johnrenner94/Encoder_IMU_Odometry_Robot/Media/ModifiedLowerChassis.jpg

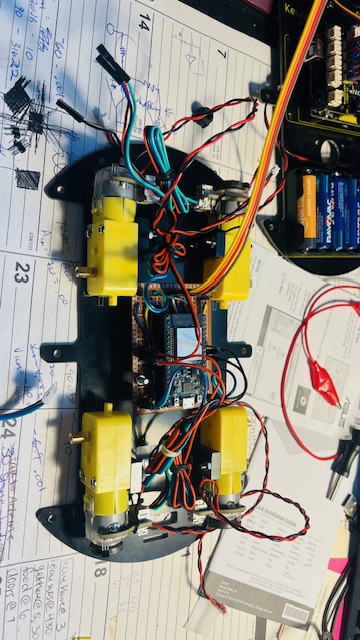
Media/ModifiedLowerChassis.jpg
