johnrenner94/Encoder_IMU_Odometry_Robot/Media/TestSetup.jpg

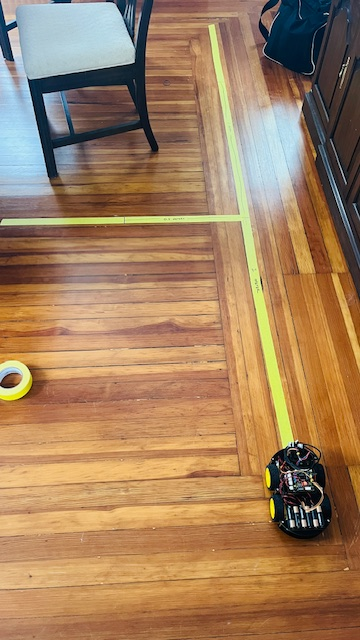
Media/TestSetup.jpg
