johnrenner94/Encoder_IMU_Odometry_Robot/Media/BreakoutBoard_no_ESP32.jpg

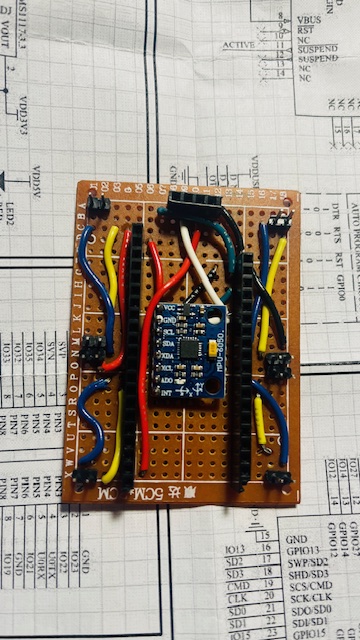
Media/BreakoutBoard_no_ESP32.jpg
