johnrenner94/Encoder_IMU_Odometry_Robot/Media/BreakoutBoard_with_ESP32.jpg

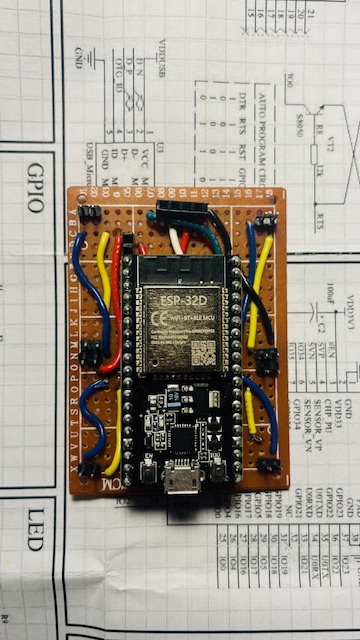
Media/BreakoutBoard_with_ESP32.jpg
