johnrenner94/Encoder_IMU_Odometry_Robot/Media/DFRobot_FIT0450_w_Encoder.jpg

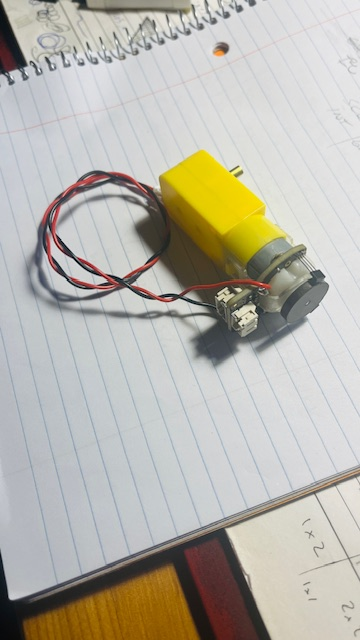
Media/DFRobot_FIT0450_w_Encoder.jpg
