johnrenner94/Encoder_IMU_Odometry_Robot/Media/Robot.jpg

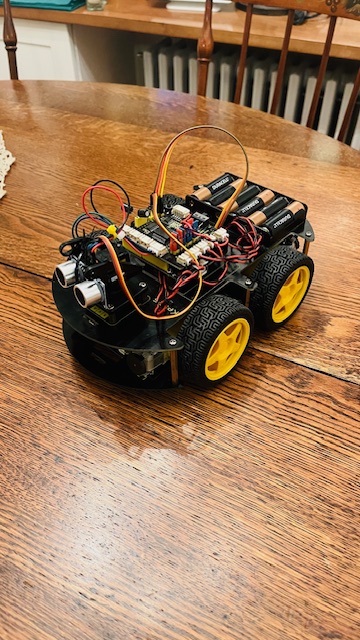
Media/Robot.jpg
