johnrenner94/Encoder_IMU_Odometry_Robot/Media/UI.png

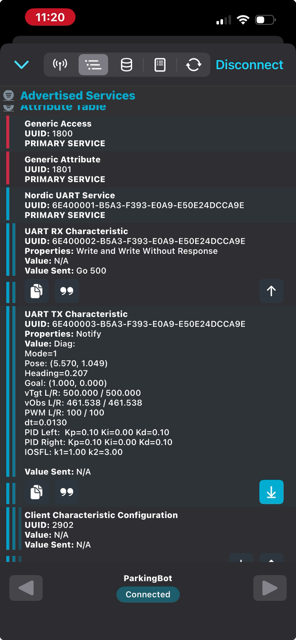
Media/UI.png
